LiAngZhou0213LiAngZhou/SignalGenerator/原理图/SCH_Schematic1_1-P1_2026-10-24.png

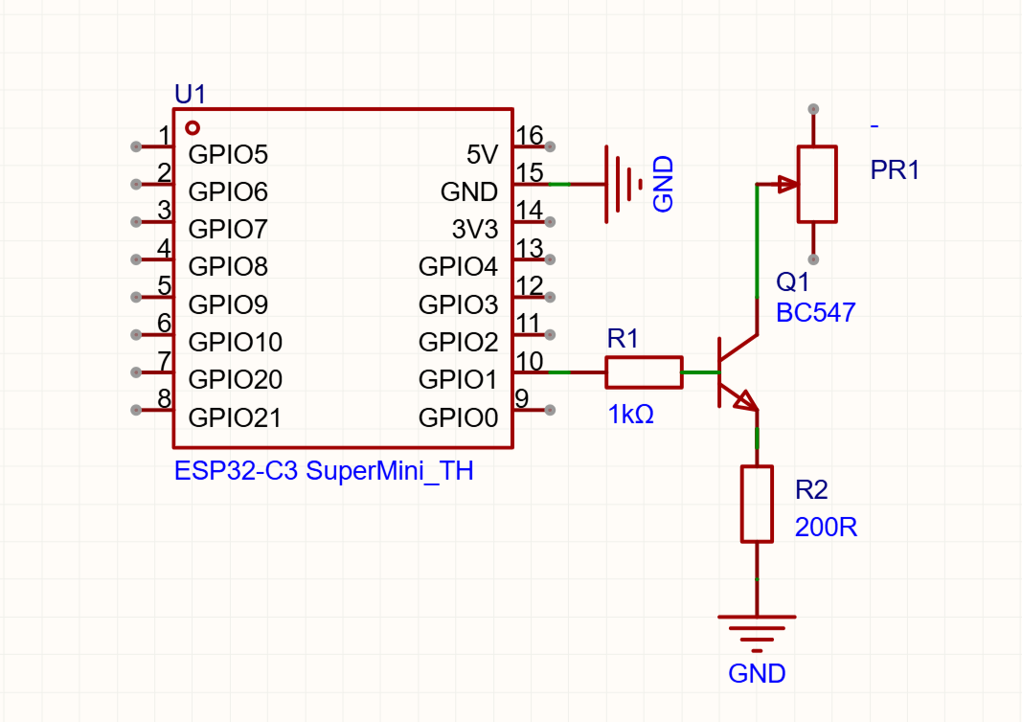
原理图/SCH_Schematic1_1-P1_2026-10-24.png
