LiAngZhou0213LiAngZhou/SignalGenerator/(commit log)

2026-10-28 Initial commit: ESP32-C3 signal generator firmware
2026-10-28 Docs: update panel page filename references to ESP32C3-SignalGen.html
2026-10-30 V2.0: 界面标注版本号、重写接线与使用说明并细化模式/参数命名，调整软件 PWM 占空比相位
